kevin-david/ha-ac-infinity-fan/(list of files, drawings)

Other design files:
electronics/ac-infinity-esphome.fzz
