kevin-david/ha-ac-infinity-fan/esphome/calibration-data.md

# Calibration Data

## Cloudline S6 measurements (2026-03-25)

| Speed | PWM Voltage (V) | Tach Pulses/min |
|---|---|---|
| 0 | ~3.16 (est.) | 0 |
| 1 | 2.33 | ~1640 |
| 2 | 2.09 | ~2290 |
| 3 | 1.92 | ~2990 |
| 4 | 1.73 | ~3690 |
| 5 | 1.59 | ~4290 |
| 6 | 1.48 | ~4890 |
| 7 | 1.375 | ~5480 |
| 8 | 1.27 | ~6130 |
| 9 | 1.19 | ~6810 |
| 10 | 1.10 (±0.01) | ~7720 (±50) |

See data in `device.yaml` as well.
