kevin-david/ha-ac-infinity-fan/(commit log)

2026-01-31 Updated with new instructions and colours to match uis scheme
    [ac-infinity-esphome.fzz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]
2026-01-31 Tidied up USB wiring and added a note about colours
2026-03-28 Clarify electronics component requirements
    Clarified ESP32 requirements (I ordered the wrong one first) and that screws should be self-tapping (was later but not earlier)
2026-03-28 Remove duplicate ESPHome device block
2026-03-28 Add calibration data for S6 model
    In case it helps others change thresholds
